he1ias/Turing-Machine/(list of files, drawings)

Other design files:
freerouter/Turing Machine.dsn
