he1ias/Turing-Machine/KiCad Project Files/Turing Machine.kicad_pcb

## KiCad design KiCad Project Files/Turing Machine.kicad_pcb (2026-11-05)

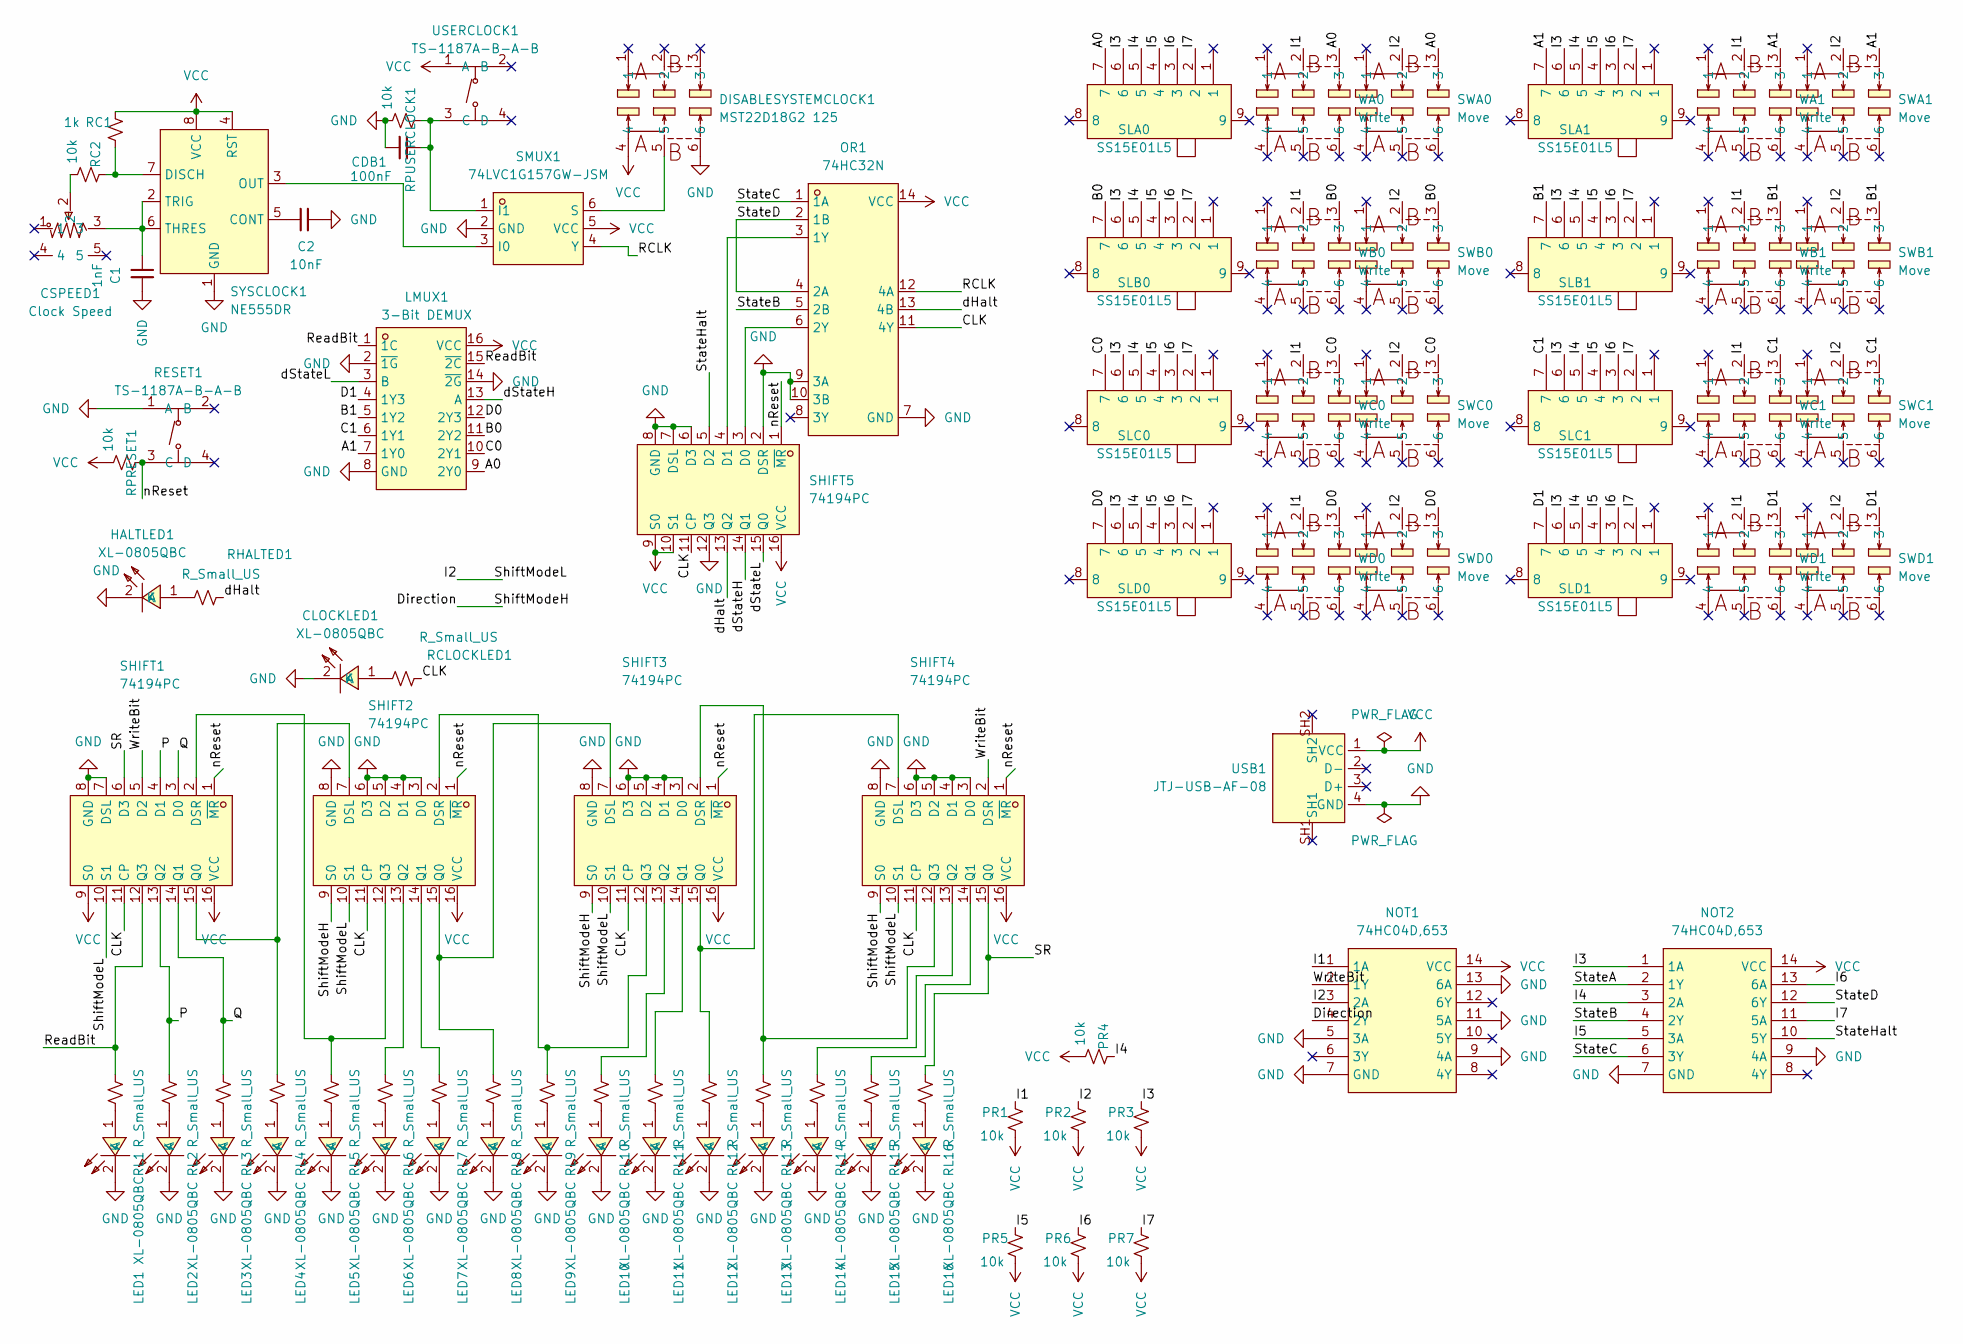
[picture p6: schematic Turing Machine.kicad_sch]

Parts:
C1: 1nF; C_Disc_D5.0mm_W2.5mm_P2.50mm
C2: 10nF; C_Disc_D5.0mm_W2.5mm_P2.50mm
CDB1: 100nF; C_Disc_D5.0mm_W2.5mm_P2.50mm
CLOCKLED1: XL-0805QBC; LED0805-R-RD; MPN KT-0805B; LCSC Part C2293
CSPEED1: Clock Speed; RES-ADJ-TH_PDB12-M4251-104BF; MPN PDB12-M4251-105BF; LCSC Part C5824127
DISABLESYSTEMCLOCK1: MST22D18G2 125; SW-SMD_MST22D18G2; MPN MST22D18G2 125; LCSC Part C2906280
HALTLED1: XL-0805QBC; LED0805-R-RD; MPN KT-0805B; LCSC Part C2293
LED1, LED2, LED3, LED4, LED5, LED6, LED7, LED8, LED9, LED10, LED11, LED12, LED13, LED14, LED15, LED16: XL-0805QBC; LED0805-R-RD; MPN KT-0805B; LCSC Part C2293
LMUX1: 3-Bit DEMUX; PDIP-16_L19.3-W6.4-P2.54-LS7.9-BL; MPN SN74LS156N; LCSC Part C1547279
NOT1, NOT2: 74HC04D,653; SOIC-14_L8.7-W3.9-P1.27-LS6.0-BL; MPN 74HC04D,653; LCSC Part C5590
OR1: 74HC32N; PDIP-14_L19.3-W6.5-P2.54-LS7.6-BL; MPN 74HC32N; LCSC Part C41427253
PR1, PR2, PR3, PR4, PR5, PR6, PR7: 10k; R1206
RC1: 1k; R1206
RC2: 10k; R1206
RCLOCKLED1: R_Small_US; R1206
RESET1: TS-1187A-B-A-B; SW-SMD_4P-L5.1-W5.1-P3.70-LS6.5-TL_H1.5; MPN TS-1187A-B-A-B; LCSC Part C318884
RHALTED1: R_Small_US; R1206
RL1, RL2, RL3, RL4, RL5, RL6, RL7, RL8, RL9, RL10, RL11, RL12, RL13, RL14, RL15, RL16: R_Small_US; R1206
RPRESET1: 10k; R1206
RPUSERCLOCK1: 10k; R1206
SHIFT1, SHIFT2, SHIFT3, SHIFT4, SHIFT5: 74194PC; PDIP-16_L19.3-W6.4-P2.54-LS7.94-BL; MPN SN74HC194N(LX); LCSC Part C22449650
SLA0, SLA1: SS15E01L5; SW-TH_SS15E01L5; MPN SS15E01L5; LCSC Part C1121868
SLB0, SLB1: SS15E01L5; SW-TH_SS15E01L5; MPN SS15E01L5; LCSC Part C1121868
SLC0, SLC1: SS15E01L5; SW-TH_SS15E01L5; MPN SS15E01L5; LCSC Part C1121868
SLD0, SLD1: SS15E01L5; SW-TH_SS15E01L5; MPN SS15E01L5; LCSC Part C1121868
SMUX1: 74LVC1G157GW-JSM; SOT-363_L2.1-W1.3-P0.65-LS2.3-BL; MPN 74LVC1G157GW-JSM; LCSC Part C49006656
SWA0, SWA1: Move; SW-SMD_MST22D18G2; MPN MST22D18G2 125; LCSC Part C2906280
SWB0, SWB1: Move; SW-SMD_MST22D18G2; MPN MST22D18G2 125; LCSC Part C2906280
SWC0, SWC1: Move; SW-SMD_MST22D18G2; MPN MST22D18G2 125; LCSC Part C2906280
SWD0, SWD1: Move; SW-SMD_MST22D18G2; MPN MST22D18G2 125; LCSC Part C2906280
SYSCLOCK1: NE555DR; SOIC-8_L4.9-W3.9-P1.27-LS6.0-BL; MPN NE555DR; LCSC Part C7593
USB1: JTJ-USB-AF-08; USB-A-TH__USB-AF-90; MPN 902-131A1011D10100; LCSC Part C2345
USERCLOCK1: TS-1187A-B-A-B; SW-SMD_4P-L5.1-W5.1-P3.70-LS6.5-TL_H1.5; MPN TS-1187A-B-A-B; LCSC Part C318884
WA0, WA1: Write; SW-SMD_MST22D18G2; MPN MST22D18G2 125; LCSC Part C2906280
WB0, WB1: Write; SW-SMD_MST22D18G2; MPN MST22D18G2 125; LCSC Part C2906280
WC0, WC1: Write; SW-SMD_MST22D18G2; MPN MST22D18G2 125; LCSC Part C2906280
WD0, WD1: Write; SW-SMD_MST22D18G2; MPN MST22D18G2 125; LCSC Part C2906280

Connections:
/A0: LMUX1.9 (2Y0), SLA0.7, SWA0.3, WA0.3
/A1: LMUX1.7 (1Y0), SLA1.7, SWA1.3, WA1.3
/B0: LMUX1.11 (2Y2), SLB0.7, SWB0.3, WB0.3
/B1: LMUX1.5 (1Y2), SLB1.7, SWB1.3, WB1.3
/C0: LMUX1.10 (2Y1), SLC0.7, SWC0.3, WC0.3
/C1: LMUX1.6 (1Y1), SLC1.7, SWC1.3, WC1.3
/CLK: OR1.11 (4Y), RCLOCKLED1.2, SHIFT1.11 (CP), SHIFT2.11 (CP), SHIFT3.11 (CP), SHIFT4.11 (CP), SHIFT5.11 (CP)
/D0: LMUX1.12 (2Y3), SLD0.7, SWD0.3, WD0.3
/D1: LMUX1.4 (1Y3), SLD1.7, SWD1.3, WD1.3
/Direction: NOT1.4 (2Y), SHIFT2.9 (S0), SHIFT3.9 (S0), SHIFT4.9 (S0)
/I1: NOT1.1 (1A), PR1.1, WA0.2, WA1.2, WB0.2, WB1.2, WC0.2, WC1.2, WD0.2, WD1.2
/I2: NOT1.3 (2A), PR2.1, SHIFT1.10 (S1), SHIFT2.10 (S1), SHIFT3.10 (S1), SHIFT4.10 (S1), SWA0.2, SWA1.2, SWB0.2, SWB1.2, SWC0.2, SWC1.2, SWD0.2, SWD1.2
/I3: NOT2.1 (1A), PR3.1, SLA0.6, SLA1.6, SLB0.6, SLB1.6, SLC0.6, SLC1.6, SLD0.6, SLD1.6
/I4: NOT2.3 (2A), PR4.1, SLA0.5, SLA1.5, SLB0.5, SLB1.5, SLC0.5, SLC1.5, SLD0.5, SLD1.5
/I5: NOT2.5 (3A), PR5.1, SLA0.4, SLA1.4, SLB0.4, SLB1.4, SLC0.4, SLC1.4, SLD0.4, SLD1.4
/I6: NOT2.13 (6A), PR6.1, SLA0.3, SLA1.3, SLB0.3, SLB1.3, SLC0.3, SLC1.3, SLD0.3, SLD1.3
/I7: NOT2.11 (5A), PR7.1, SLA0.2, SLA1.2, SLB0.2, SLB1.2, SLC0.2, SLC1.2, SLD0.2, SLD1.2
/P: RL2.1, SHIFT1.4 (D1), SHIFT1.13 (Q2)
/Q: RL3.1, SHIFT1.3 (D0), SHIFT1.14 (Q1)
/RCLK: OR1.12 (4A), SMUX1.4 (Y)
/ReadBit: LMUX1.1 (1C), LMUX1.15 (~2C), RL1.1, SHIFT1.12 (Q3)
/SR: RL16.1, SHIFT1.6 (D3), SHIFT4.15 (Q0)
/StateA: NOT2.2 (1Y)
/StateB: NOT2.4 (2Y), OR1.5 (2B)
/StateC: NOT2.6 (3Y), OR1.1 (1A)
/StateD: NOT2.12 (6Y), OR1.2 (1B), OR1.4 (2A)
/StateHalt: NOT2.10 (5Y), SHIFT5.5 (D2)
/WriteBit: NOT1.2 (1Y), SHIFT1.5 (D2), SHIFT4.2 (DSR)
/dHalt: OR1.13 (4B), RHALTED1.2, SHIFT5.13 (Q2)
/dStateH: LMUX1.13 (A), SHIFT5.14 (Q1)
/dStateL: LMUX1.3 (B), SHIFT5.15 (Q0)
/nReset: RESET1.3 (C), RPRESET1.1, SHIFT1.1 (~MR), SHIFT2.1 (~MR), SHIFT3.1 (~MR), SHIFT4.1 (~MR), SHIFT5.1 (~MR)
GND: C1.2, C2.2, CDB1.1, CLOCKLED1.2 (K), DISABLESYSTEMCLOCK1.6, HALTLED1.2 (K), LED1.2 (K), LED2.2 (K), LED3.2 (K), LED4.2 (K), LED5.2 (K), LED6.2 (K), LED7.2 (K), LED8.2 (K), LED9.2 (K), LED10.2 (K), LED11.2 (K), LED12.2 (K), LED13.2 (K), LED14.2 (K), LED15.2 (K), LED16.2 (K), LMUX1.2 (~1G), LMUX1.8 (GND), LMUX1.14 (~2G), NOT1.5 (3A), NOT1.7 (GND), NOT1.9 (4A), NOT1.11 (5A), NOT1.13 (6A), NOT2.7 (GND), NOT2.9 (4A), OR1.7 (GND), OR1.9 (3A), OR1.10 (3B), RESET1.1 (A), RPUSERCLOCK1.2, SHIFT1.7 (DSL), SHIFT1.8 (GND), SHIFT2.3 (D0), SHIFT2.4 (D1), SHIFT2.5 (D2), SHIFT2.6 (D3), SHIFT2.8 (GND), SHIFT3.3 (D0), SHIFT3.4 (D1), SHIFT3.5 (D2), SHIFT3.6 (D3), SHIFT3.8 (GND), SHIFT4.3 (D0), SHIFT4.4 (D1), SHIFT4.5 (D2), SHIFT4.6 (D3), SHIFT4.8 (GND), SHIFT5.2 (DSR), SHIFT5.6 (D3), SHIFT5.7 (DSL), SHIFT5.8 (GND), SHIFT5.12 (Q3), SMUX1.2 (GND), SYSCLOCK1.1 (GND), USB1.4 (GND)
unnamed: CLOCKLED1.1 (A), RCLOCKLED1.1
unnamed: CSPEED1.2, RC2.2
unnamed: HALTLED1.1 (A), RHALTED1.1
unnamed: LED1.1 (A), RL1.2
unnamed: LED2.1 (A), RL2.2
unnamed: LED3.1 (A), RL3.2
unnamed: LED4.1 (A), RL4.2
unnamed: LED5.1 (A), RL5.2
unnamed: LED6.1 (A), RL6.2
unnamed: LED7.1 (A), RL7.2
unnamed: LED8.1 (A), RL8.2
unnamed: LED9.1 (A), RL9.2
unnamed: LED10.1 (A), RL10.2
unnamed: LED11.1 (A), RL11.2
unnamed: LED12.1 (A), RL12.2
unnamed: LED13.1 (A), RL13.2
unnamed: LED14.1 (A), RL14.2
unnamed: LED15.1 (A), RL15.2
unnamed: LED16.1 (A), RL16.2
unnamed: OR1.3 (1Y), SHIFT5.4 (D1)
unnamed: OR1.6 (2Y), SHIFT5.3 (D0)
unnamed: RL5.1, SHIFT1.2 (DSR), SHIFT2.12 (Q3)
unnamed: RL4.1, SHIFT1.15 (Q0), SHIFT2.7 (DSL)
unnamed: RL9.1, SHIFT2.2 (DSR), SHIFT3.12 (Q3)
unnamed: RL8.1, SHIFT2.15 (Q0), SHIFT3.7 (DSL)
unnamed: RL7.1, SHIFT2.14 (Q1)
unnamed: RL6.1, SHIFT2.13 (Q2)
unnamed: RL13.1, SHIFT3.2 (DSR), SHIFT4.12 (Q3)
unnamed: RL12.1, SHIFT3.15 (Q0), SHIFT4.7 (DSL)
unnamed: RL11.1, SHIFT3.14 (Q1)
unnamed: RL10.1, SHIFT3.13 (Q2)
unnamed: RL15.1, SHIFT4.14 (Q1)
unnamed: RL14.1, SHIFT4.13 (Q2)
unnamed: SMUX1.3 (I0), SYSCLOCK1.3 (OUT)
unnamed: CDB1.2, RPUSERCLOCK1.1, SMUX1.1 (I1), USERCLOCK1.3 (C)
unnamed: DISABLESYSTEMCLOCK1.5, SMUX1.6 (S)
unnamed: C2.1, SYSCLOCK1.5 (CONT)
unnamed: RC1.1, RC2.1, SYSCLOCK1.7 (DISCH)
unnamed: C1.1, CSPEED1.3, SYSCLOCK1.2 (TRIG), SYSCLOCK1.6 (THRES)
VCC: DISABLESYSTEMCLOCK1.4, LMUX1.16 (VCC), NOT1.14 (VCC), NOT2.14 (VCC), OR1.14 (VCC), PR1.2, PR2.2, PR3.2, PR4.2, PR5.2, PR6.2, PR7.2, RC1.2, RPRESET1.2, SHIFT1.9 (S0), SHIFT1.16 (VCC), SHIFT2.16 (VCC), SHIFT3.16 (VCC), SHIFT4.16 (VCC), SHIFT5.9 (S0), SHIFT5.10 (S1), SHIFT5.16 (VCC), SMUX1.5 (VCC), SYSCLOCK1.4 (RST), SYSCLOCK1.8 (VCC), USB1.1 (VCC), USERCLOCK1.1 (A)

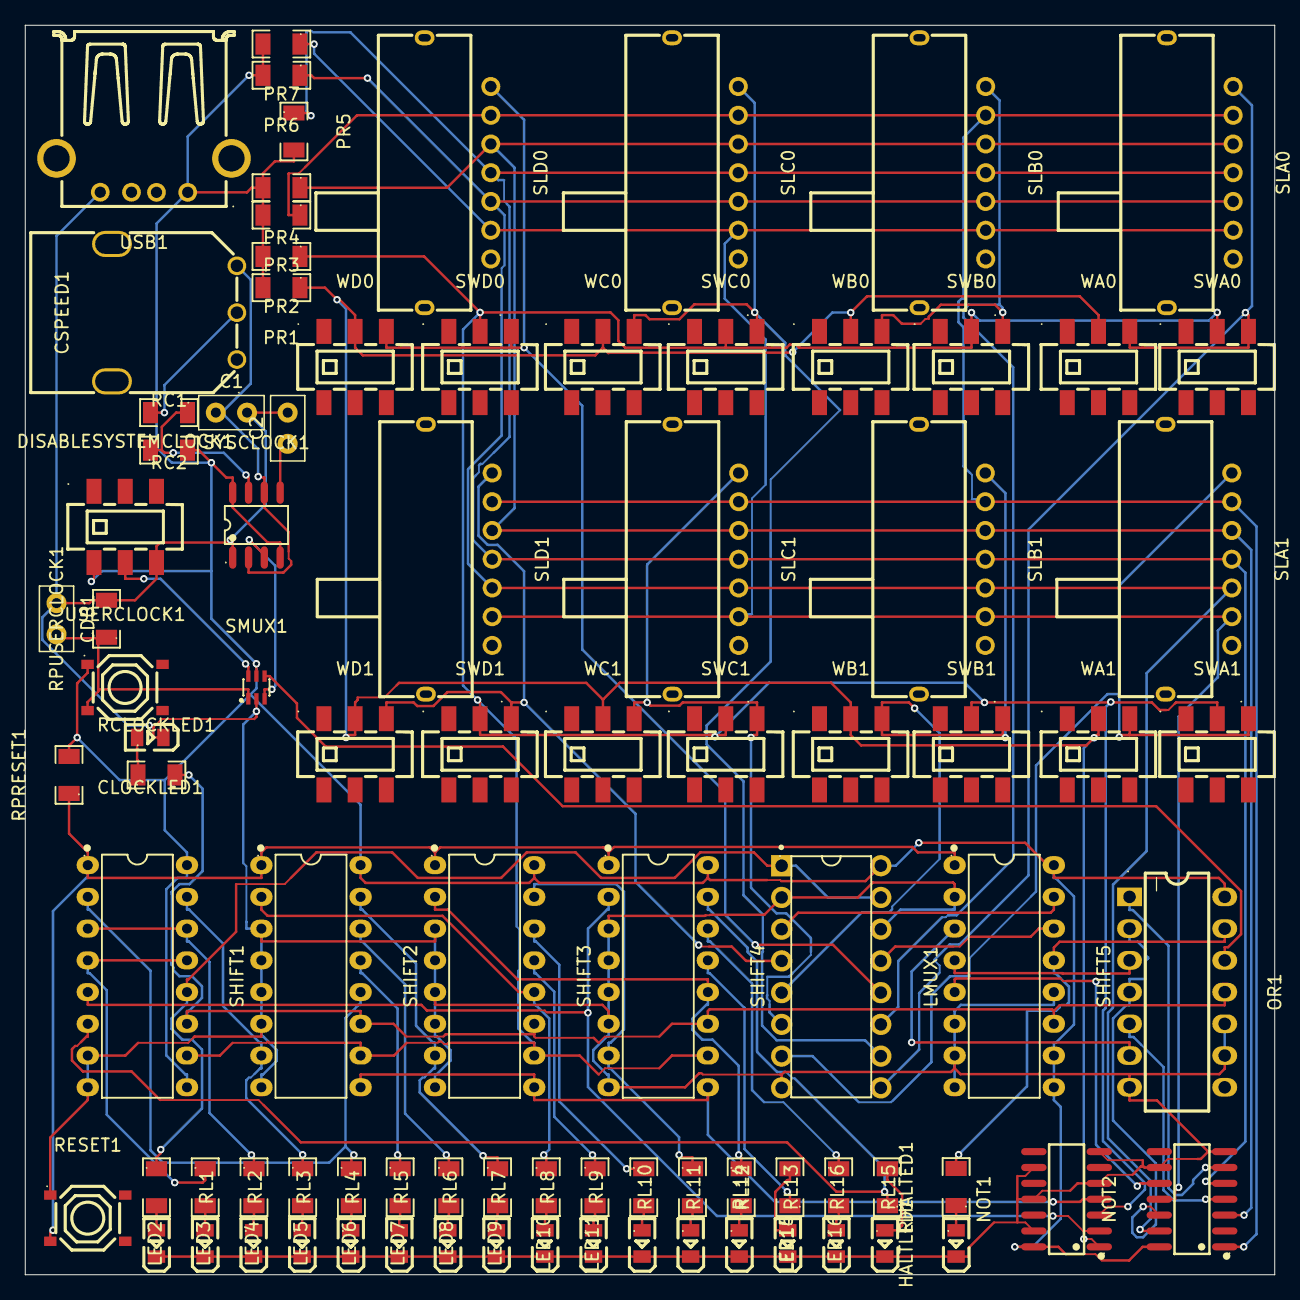
[picture p7: board Turing Machine.kicad_pcb from above]

Board: 2 copper layers, 100.0 x 100.0 mm, 90 parts (0 on the bottom side), 72 nets.
