he1ias/Turing-Machine/JOURNAL.md

# Turing Machine: devlog

<!-- Generated by Half Life from project zqss6d814ljoa5y9othud61v. Edits here are overwritten on the next sync. -->
<!-- Generated: 2026-11-05T13:35:32.212Z -->

> [!NOTE]
> This devlog is mirrored from [Half Life](https://halflife.hackclub.com) ([open the project](https://halflife.hackclub.com/projects/zqss6d814ljoa5y9othud61v)). Editing it here will not change the platform's copy, and the next sync overwrites this file.

> A 4-state Turing Machine with a 16-bit memory tape that runs on a PCB.

| Week | Tier | Hours logged | Entries |
| --- | --- | --- | --- |
| Week 5 | Tier 3 | 31h | 3 |

## Contents

1. [2026-11-03: ## W5: Turing Machine](#2026-11-03-w5-turing-machine)
2. [2026-11-04: ## W5: Turing Machine](#2026-11-04-w5-turing-machine)
3. [2026-11-05: ## W5: Turing Machine](#2026-11-05-w5-turing-machine)

## Design

### 2026-11-03: ## W5: Turing Machine

**8h**

## W5: Turing Machine
### Prototyping the circuit

For this week's project, I wanted to stick with the breadboard computer theme, and build my own 4-state Turing machine, capable of running small programs.

Instead of breadboards, I'm thinking I'll design a PCB and use JLC's PCBA to skip the time consuming soldering / wire cutting & placing I would have to do otherwise. This means I'll have to keep the parts I use simple to keep costs down.

As I only want to run small 4-state machine, I decided my user input will be entirely made of switches, rather than trying to get a small EEPROM to work. The 16 outputs will each have their own LED indicator for their value, as well as an additional LED indicating where the program head is. The head will wrap around the 16 bits, so I'll need to use shift registers.

Additionally, the clock speed can be controlled, or disabled to let the user manually step through the program.

With the plan out of the way, I booted up Seb Lague's `Digital-Logic-Sim` to wire up my circuit. I've had some experience with this tool before, but designing a full computer was much harder than I thought it'd be.

### Prototyping the circuit

I fully intend to redo the wiring in Logisim afterwards, but I thought doing a prototype in Digital-Logic-Sim would be a good way work out the key features I need.

I started by designing the clock pulse. On my PCB, the user should be able to choose how fast it goes, as well as whether the ticking is manual or automatic:



I then designed a 4-bit shift register. It takes serial L and R data, so it can be chained, and you can choose which direction to shift in. An earlier version looked like this:



Chaining them together, we get 16-bit shifting.



I needed to add a 'reset' button however. Clearing the registers is easy, however setting the low bit afterwards took quite a lot of work. My solution in the end cleared the registers on the 'reset' buttons rising edge, and stored the bit on the falling edge:



I then created the actual registers, which will store data on the tape. The head bit controls which position is read & written to.



...and chained together:



 I then added the state information itself. On the PCB, these will simply be switches, however here I've used a small ROM. I needed to use lots of D-Latches to prevent any feedback loops, so the wiring did get quite messy.



At this point, the computer is mostly done, however I found that the output was a bit inconsistent and wasn't giving the expected result. I found this to be the result of a few race conditions, as well as incorrect logic in my circuit.

After (somewhat) simplifying the circuit and removing unnecessary 'pulse' blocks, the machine finally works! I tested it by running the largest 'Busy Beaver' 4-state machine on it (search it up!), and exactly 107 steps later, the 'halt' flag was triggered and 13 LEDs were lit up in the output (the maximum!).



I still have some work to do massively simplifying the circuit, and getting rid of redundant logic gates.I intend to complete this in Logisim, before translating the circuit into real electronics in KiCad.

Thanks for reading!

### 2026-11-04: ## W5: Turing Machine

**8h**

## W5: Turing Machine
### Finalising the circuit in Logisim

This session was spent simplifying and polishing the circuit I previously made in Seb Lague's `Digital-Logic-Sim` program. I was new to Logisim and so this session took quite a lot of time to complete, however I'm very happy with the results.

I started by wiring the clock circuit:



I then added the first row of shift registers.



At this point, I was still following my prototype circuit, and I was about to add another row of shifters. However, I realised that the design could be greatly simplified if I got rid of that second row - making the * tape * shift instead of the head.

I left this for the moment however, as I needed to work out the user input.

I decided on a 4 x 2 7-bit approach - 4 rows for each state, 2 columns for which bit was read, and 7 bits for which bit to right, which direction to move, and the remaining five will correspond to a slide switch that selects which state to transition into.

It came out a bit like this:



The labels all connect up to these buses:



I chose this approach as it would only require one multiplexer, rather than 7 which would be if I was to select each bit individually. However, I'm not 100% confident this setup will work with real electronics, so I will have to confirm this when I wire this up in KiCad.

At this point my circuit looked like the following. It was almost complete, however I still needed to add halting logic:



I did this by using a chain of shift registers, although I did think this was somewhat wasteful:



Putting it all together, I arrived at the following:



I made a list of required parts for this design:

```
Required Parts:

7 x Shift Register (74194)

1 x Clock (555)

8 x Resistors (Pulldown)

8 x 5-Position Slide Switches
17 x 2-Position Slide Switches
2 x Button
2 x Pentiometer (Brightness Control, Clock Speed)

2 x 8-Bit LED Arrays
2 x LED (Clock, Halt)
         OR
18 x LED (Clock, Halt, Tape)

1 x Power Supply

1 x AND Gate
5 x NOT Gate
2 x OR Gate
4 x Tri-State-Buffer

1 x Demultiplexer
```

Much better than the first design, however, I felt there was still some simplification to be done.

It took quite a lot of work, however I managed to remove a good number of unnecessary logic gates, wires, and shift registers.

I arrived at the following:



All thats left to do is wire it up in KiCad.

Thanks for reading!

### 2026-11-05: ## W5: Turing Machine

**15h**

## W5: Turing Machine
### Finishing the schematic & PCB

I really locked in today... I forced myself to do such a long session because I have exams in about 3 days time and haven't started studying yet... I'm kind of regretting my decision to make such a large project at this point in time, but oh well. It's finished!!! And I'm very happy with how it turned out (even if it was wayyyyy over my budget!!!).

Here's what I did this session:

### The schematic

Firstly, I had to source all my parts. Luckily this wasn't too hard, and with the `easyeda2kicad` library I had all the footprints I needed in KiCad:

IMG_8541 Large

I then started translating, to the best of my ability, the logic I had in my Logisim file to my KiCad schematic.

I first did the shift register logic:

IMG_8543 Large

IMG_8544 Large

...and clock functionality:

IMG_8547 Large

and a few other bits and pieces:

IMG_8548 Large

IMG_8549 Large

IMG_8551 Large

I then had to do I bit of thinking about my input logic. Basically, the Logisim routing I had didn't correspond to any real multiplexer chip, so I had to rewire the Logisim input to make it work in the real world.

After connecting up all my inputs, I ended up with the following:

IMG_8552 Large

My schematic was well and truly coming together!

At this point, it looked like this:

IMG_8553 Large

I then had to check for unity between the Logisim circuit and the KiCad schematic. This included checking that each component I picked was suitable for the job, and also adding smaller pieces like capacitors to make sure the final circuit was robust.

My final schematic looked like this:

IMG_8554 Large

### The PCB

With the schematic out of the way, I turned my focus to the PCB.

I was struggling to import the footprints into the PCB editor. I found that I had to reimport all my components with the `easyeda2kicad` library, with 'overwrite' selected.

IMG_8555 Large

IMG_8556 Large

I then arranged my components. This took wayyy too long, as I didn't have a whole lot of room to work with, however this step was very important to get write as the success of my routing would depend on it. I ended up with the following:

IMG_8562 Large

IMG_8559 Large

I then routed my wires (thank god for auto routing!).

IMG_8563 Large

While I was lucky I got through this phase with relatively few hiccups, I still spent soooo much time on the routing at the autorouter kept missing tiny details I had to debug and fix.

I then added a ground fill layer, and after passing DRC I was good to go!

IMG_8567 Large

The final PCB looks like this!

IMG_8568 Large

### Finishing touches

I then exported fabrication outputs and put them in JLC PCB. Even with cost cutting measures, like only using PCBA for SMD components, the final price ended up at about $75 dollars, wayy more than I was expecting. I still need to buy the rest of the components too, with a total of about $90.

The PCBA should look like this: I will hand solder the through hold components.

IMG_8569 Large

I then finished my README, and touched up my BOM.md file.

That wraps up this weeks project! A lot of effort went in this week but I am very proud of how well this turned out and how far I've come since the W1 project (which for me consisted of two buttons, an LED array and a microcontroller haha).

It's now 1AM so I should probably get to bed!

Thanks so much for reading :)
