he1ias/Turing-Machine/(commit log)

2026-11-05 Sync Turing Machine from Half Life
    [BOM.csv]
2026-11-05 Project Files, Images
    [BOM (All parts).csv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]
